nprimavera/Solar-Tracker-Project/Final design 1.7.jpg

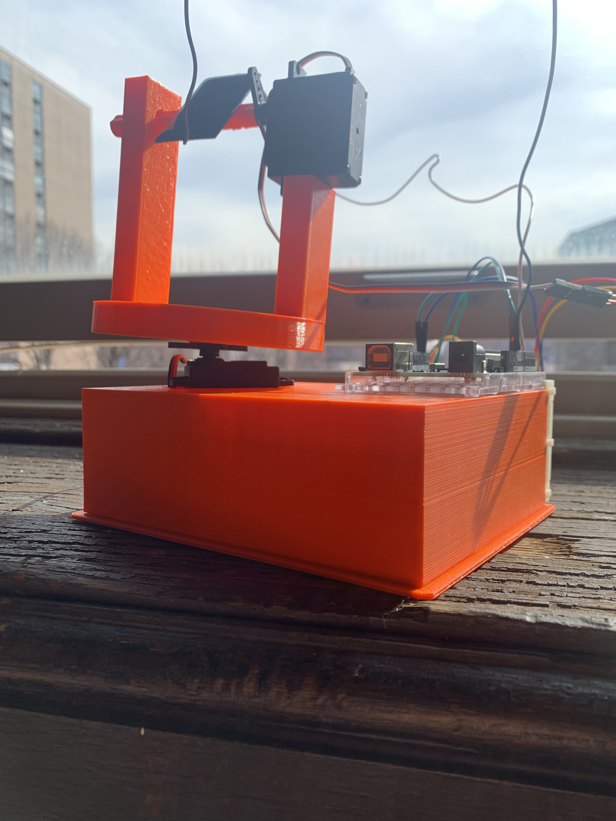
Final design 1.7.jpg
