nprimavera/Solar-Tracker-Project/Final design 1.3.jpg

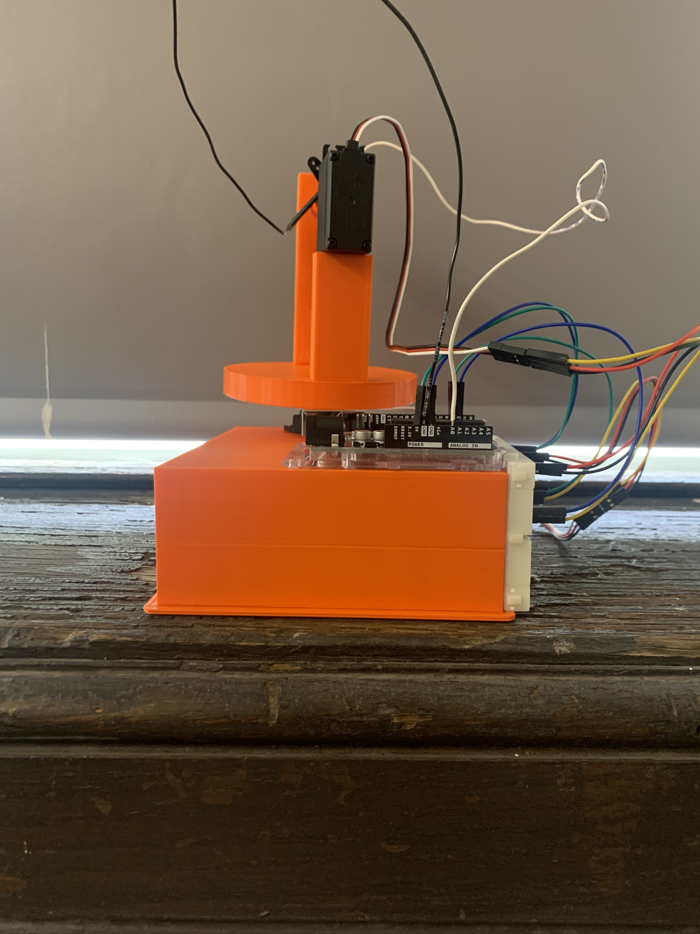
Final design 1.3.jpg
