nprimavera/Solar-Tracker-Project/Final design 1.0.jpg

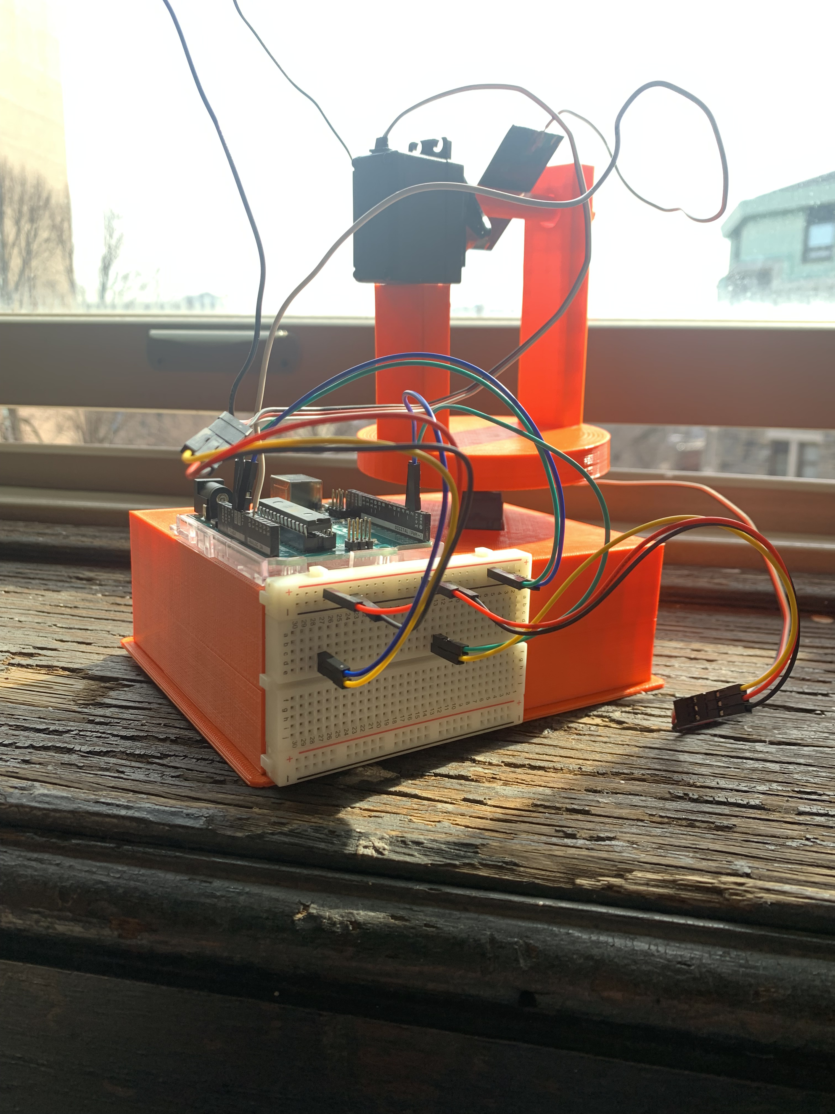
Final design 1.0.jpg
