nprimavera/Solar-Tracker-Project/Final design 1.1.jpg

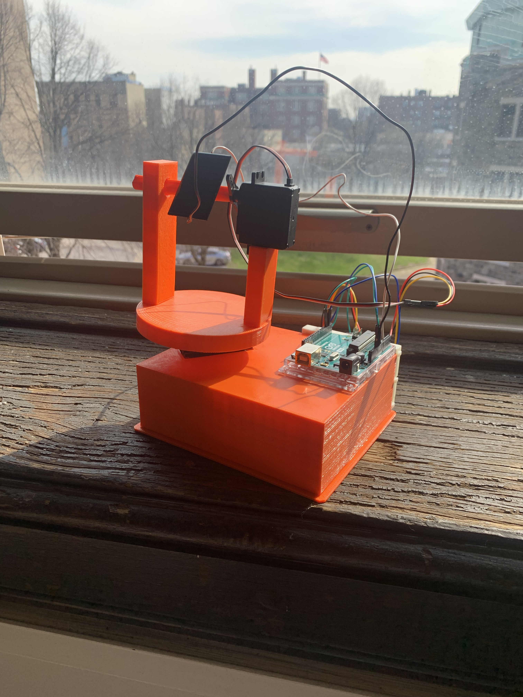
Final design 1.1.jpg
