nprimavera/Solar-Tracker-Project/Final design 1.2.jpg

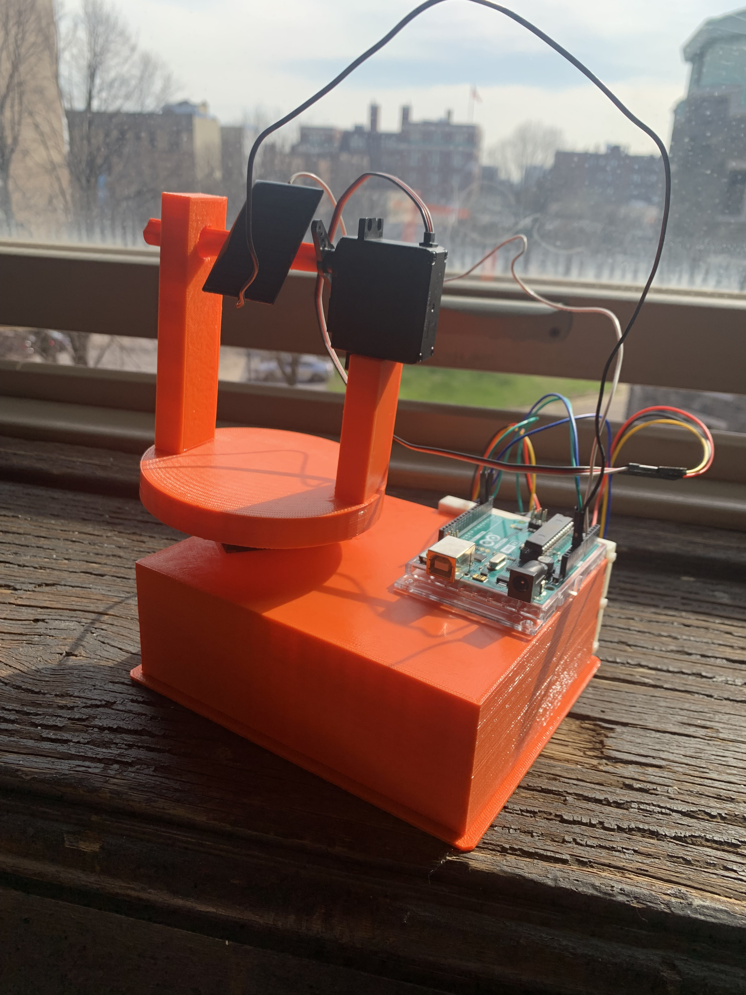
Final design 1.2.jpg
