nprimavera/Solar-Tracker-Project/Final design 1.5.jpg

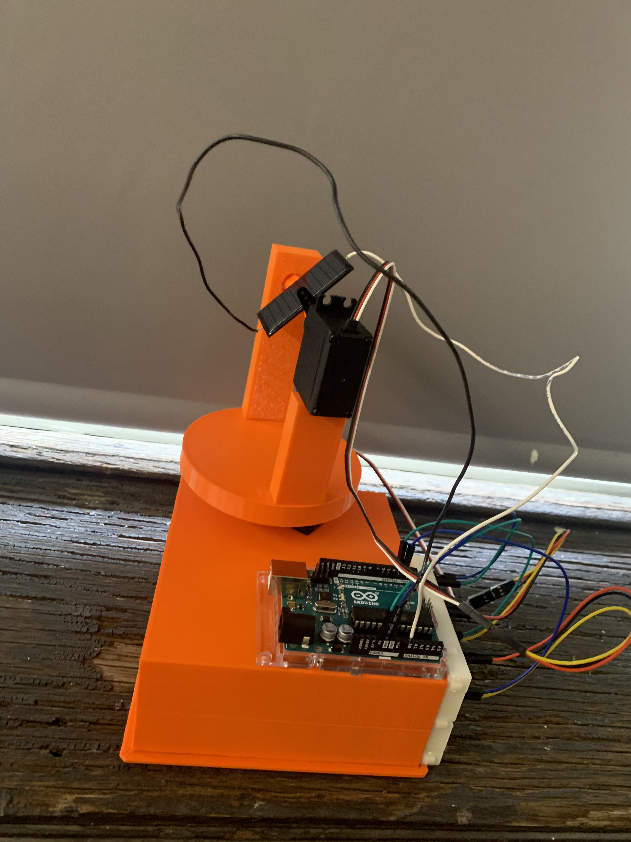
Final design 1.5.jpg
