nprimavera/Solar-Tracker-Project/Final design 1.6.jpg

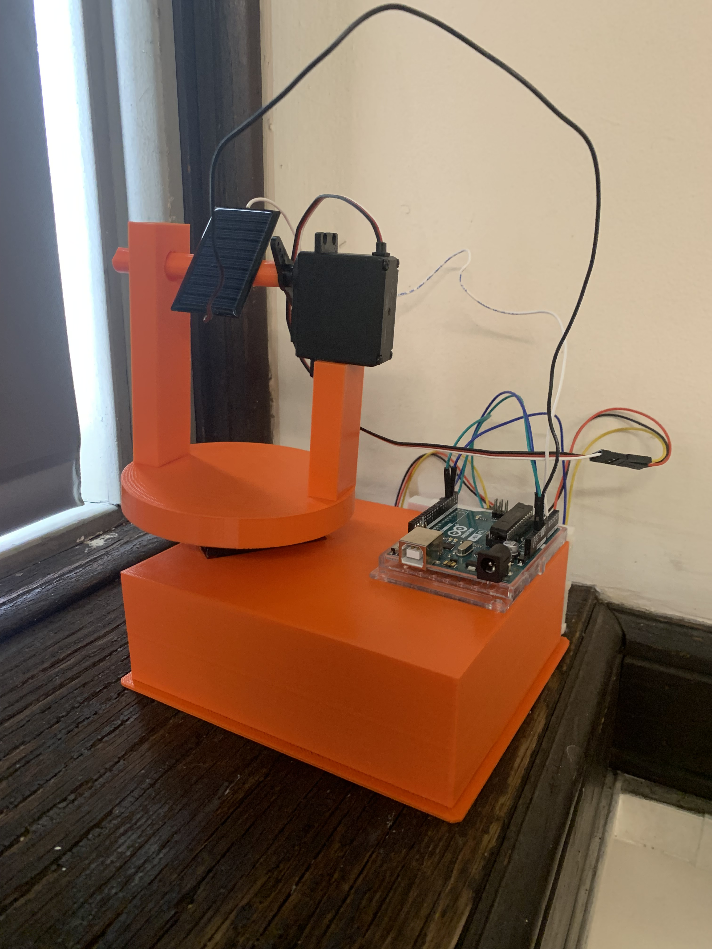
Final design 1.6.jpg
