nprimavera/Solar-Tracker-Project/Final design 1.4.jpg

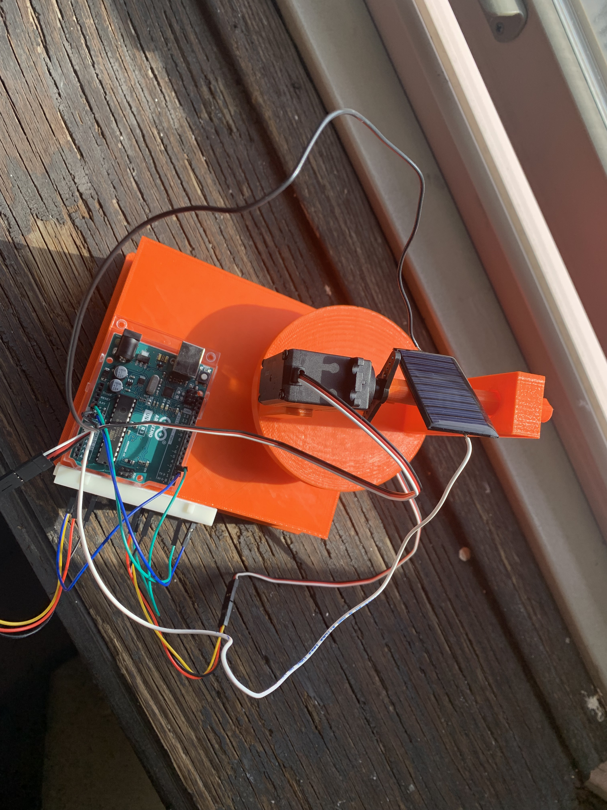
Final design 1.4.jpg
